GSRISHANTH/Real-Time-Automotive-Monitoring-and-Control-System-Using-CAN-Bus-Communication-/README.md

# Real-Time-Automotive-Monitoring-and-Control-System-Using-CAN-Bus-Communication-
Real-time automotive monitoring and control system using CAN communication between ESP32 and Arduino Uno. The system performs obstacle and light detection using ultrasonic and LDR sensors, transmits sensor data over CAN bus using MCP2515 modules, and controls motors and buzzer for intelligent safety automation.
